vthinh-la/FPGA-Line-Follower-Robot/mechanical/specs.md

# Thông Số Kỹ Thuật Cơ Khí & Kích Thước Khung Xe

Thông số hình học, trọng lượng và kích thước chi tiết của Robot Dò Line FPGA.

| Chỉ số / Kích thước | Thông số kỹ thuật | Phương pháp xác minh |
| :--- | :--- | :--- |
| **Cấu hình dẫn động** | 3 bánh dạng Delta (2 bánh sau dẫn động độc lập, 1 bi cầu trước) | Đo đạc trên nguyên mẫu thực tế |
| **Chiều dài tổng thể** | ~230 mm | Thước kẹp / Thước đo cơ khí |
| **Chiều rộng cơ sở (Vệt bánh sau)** | ~165 mm | Đo từ tâm bánh trái sang tâm bánh phải |
| **Chiều dài cơ sở** | ~175 mm | Đo từ trục bánh sau đến tâm bi cầu trước |
| **Khoảng nhô cảm biến** | ~35 mm | Đo từ tâm bi cầu trước đến mặt phẳng mắt cảm biến |
| **Đường kính bánh xe** | 42 mm (Đã bao gồm lốp cao su silicon) | Thước kẹp điện tử |
| **Bề rộng lốp** | 22 mm | Thước kẹp điện tử |
| **Khối lượng xe (Chưa có pin)** | ~210 g | Cân điện tử |
| **Khối lượng bay (Kèm pin LiPo 3S 650mAh)** | ~285 g | Cân điện tử |
| **Phân bổ trọng tâm (CoG)** | Trọng tâm thấp, dồn 65% về trục sau | Tối ưu bám đường cho bánh dẫn động |
