vthinh-la/FPGA-Line-Follower-Robot/hardware/pcb/PCB_Layout.png

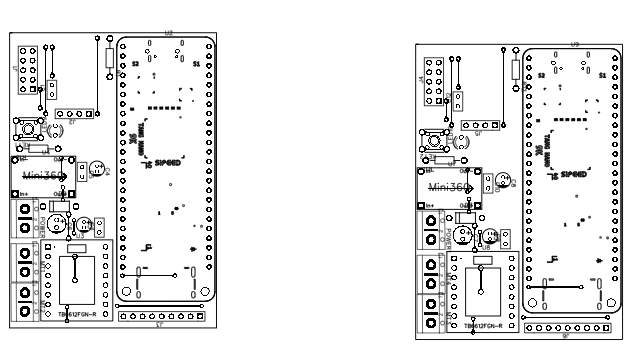
hardware/pcb/PCB_Layout.png
