vthinh-la/FPGA-Line-Follower-Robot/hardware/schematics/Schematic_FPGA.png

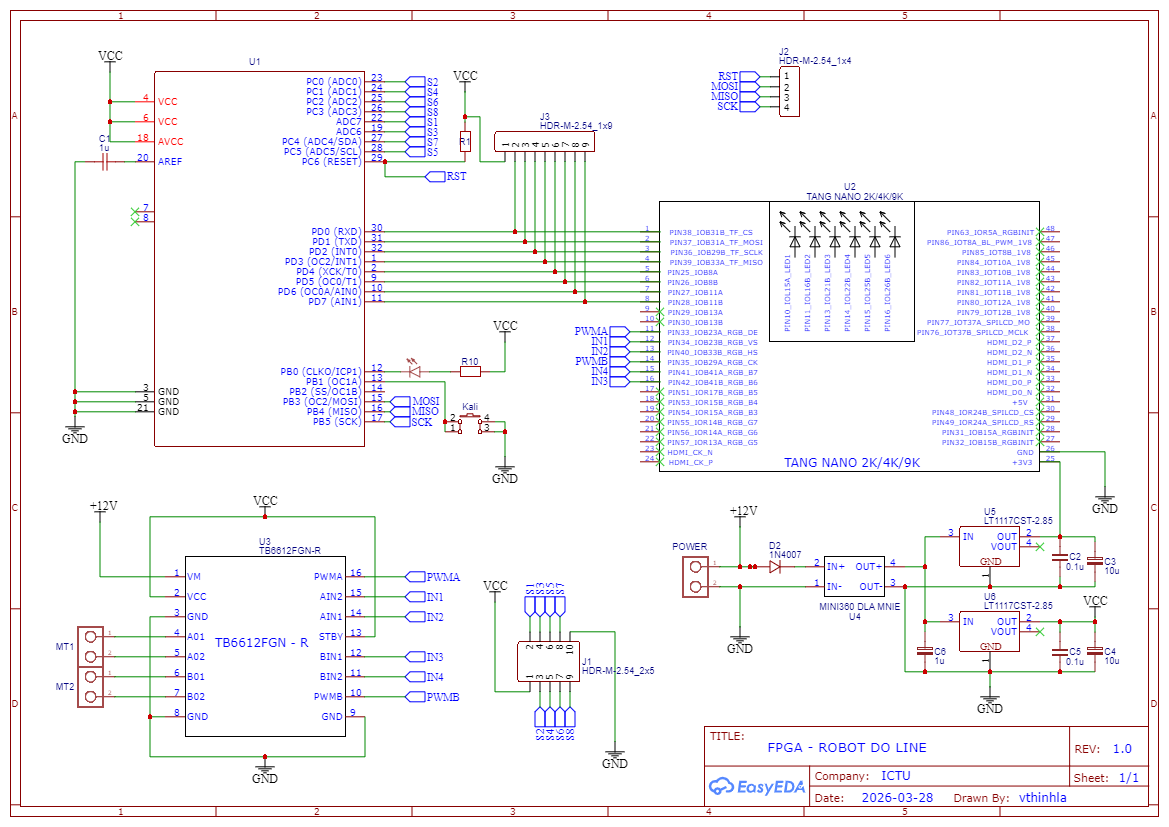
hardware/schematics/Schematic_FPGA.png
