vthinh-la/FPGA-Line-Follower-Robot/mechanical/3d_models/chassis_frame.stl

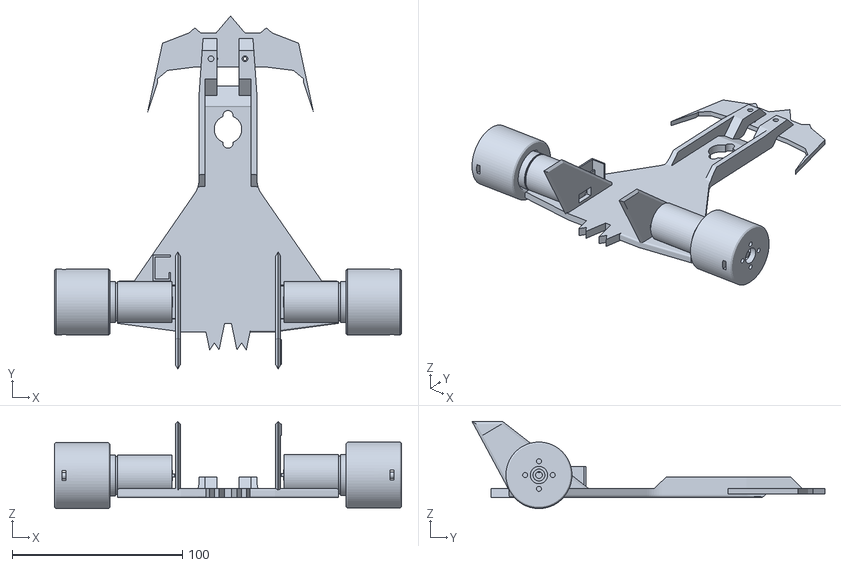
[picture p7: CAD file, 2026-10-18]
mechanical/3d_models/chassis_frame.stl
204.0 x 207.5 x 51.2
