vthinh-la/FPGA-Line-Follower-Robot/(commit log)

2026-10-18 feat: initialize open-source hardware repository for FPGA High-Speed Line Follower Robot
    [chassis_frame.stl]
2026-10-18 docs: translate documentation to Vietnamese and update control algorithm description to PID
2026-10-18 refactor: align Verilog main.v comments/signals with PID architecture and update BOM with schematic ref designators
